CAJ1314/2027-smart-sorting-system-/双板通信测试说明.md

# 双板释放通信测试

分别打开 F407程序/Project.uvprojx 和 F103程序/Project.uvprojx，分别下载到对应芯片，不能交叉下载。

接线：F407 PD8(TX) -> F103 PA10(RX)；F407 PD9(RX) <- F103 PA9(TX)；两板GND相连。F103 SG90信号PA1。舵机使用合适独立电源并共地，不从GPIO取电。

F407 USART3 / F103 USART1：115200，8N1。RELEASE\r\n：释放请求；ACK\r\n：已接收；DONE\r\n：定时动作结束；ERR\r\n：无效指令。

先启动F103，舵机85度待机；再启动F407。上层保持现有PC7流程，XY正常到放料坐标并打开夹爪后等待500ms，发送一次RELEASE。下层设置5度并保持1000ms，再设置85度并等待500ms，回复DONE。打开保持时间从设置5度开始计时，并非检测到5度后计时；没有位置反馈。

F407最多等3000ms，无自动重发。超时后结束本轮，等待下一次按键，不是永久故障锁定。Debugger Watch：BoardUART_ReleaseStatus=0等待、1收到DONE、2超时；F103 Release_Count记录释放次数，Release_State=1动作中、0待机。

当前只测试通信和下层SG90，不启用转盘/光电门，不传类别。ACK/DONE无任务编号，仅适合此串行单任务测试；正式流程需加入任务编号、防重和故障处理。

仅已完成源码与Keil编译，未进行下载或硬件验证。先空载验证关闭/打开方向及机械限位，避免85度或5度造成堵转。
