CAJ1314/2027-smart-sorting-system-/F407程序/TJC屏幕资源_导入用/资源编号说明.txt

淘晶驰串口屏资源导入说明

物料图片_61x34\00.png 至 48.png 对应校赛备份中的49张表格缩略图。
F407代码图片ID从1开始：文件00.png -> 图片ID 1，依次递增，文件48.png -> 图片ID 49。
背景图建议作为图片ID 0。中文字库参考 font16.zi。
F407串口屏UI需要 page main，以及每行控件 tName0..5、pItem0..5、nCount0..5。
注意：原备份ZIP未包含可编辑HMI工程文件或编译后的TFT屏幕固件。
