CAJ1314/2027-smart-sorting-system-/F407程序/TJC屏幕资源_导入用/背景_480x272.png

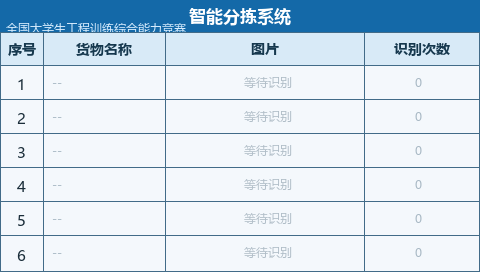
F407程序/TJC屏幕资源_导入用/背景_480x272.png
