CAJ1314/2027-smart-sorting-system-/装置零件建模/夹爪/上层集成支架.SLDPRT

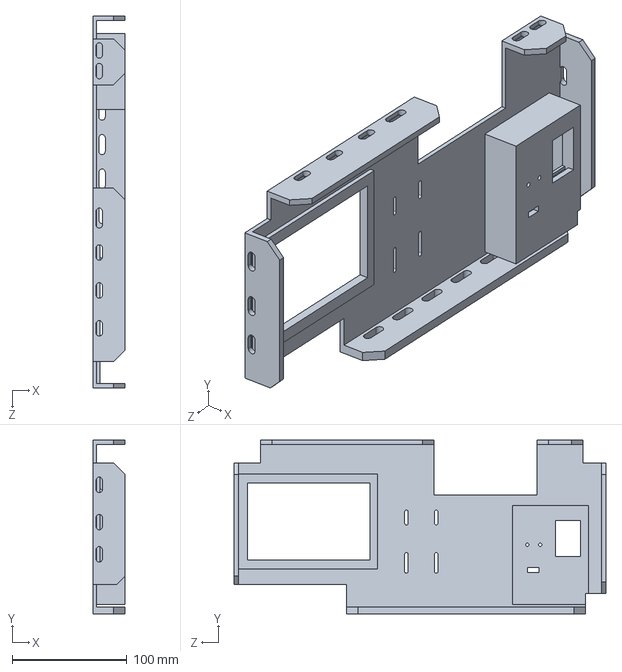
[picture p3: CAD file, 2026-11-10]
装置零件建模/夹爪/上层集成支架.SLDPRT
28.0 x 151.5 x 324.0 mm
