CAJ1314/2027-smart-sorting-system-/装置零件建模/夹爪/夹爪座.SLDPRT

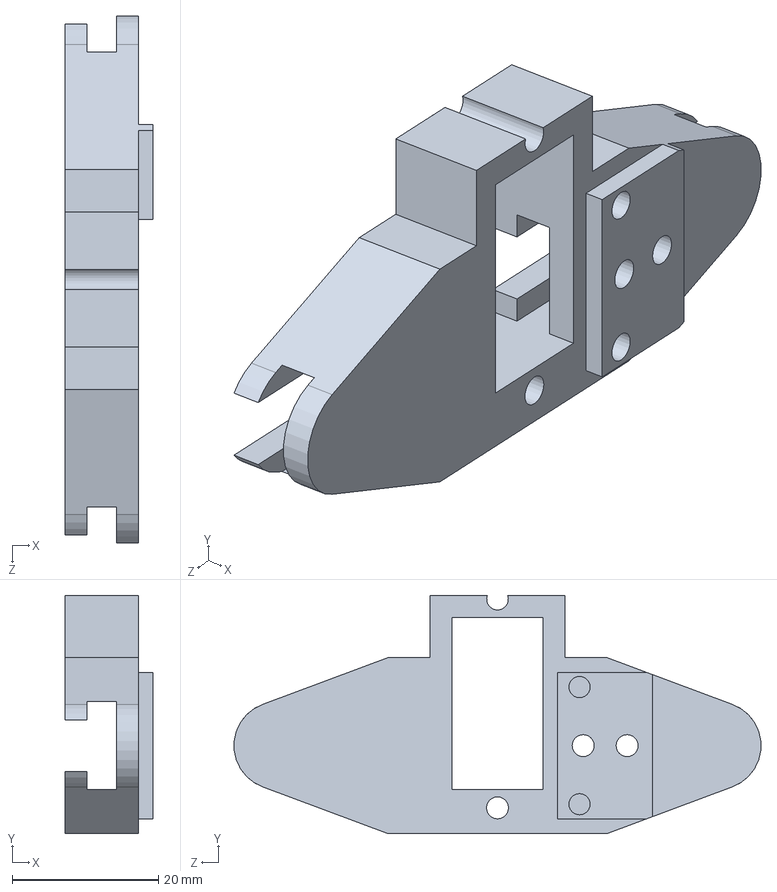
[picture p4: CAD file, 2026-11-10]
装置零件建模/夹爪/夹爪座.SLDPRT
12.0 x 32.5 x 71.9 mm
