CAJ1314/2027-smart-sorting-system-/装置零件建模/夹爪/摄像头2支架.SLDPRT

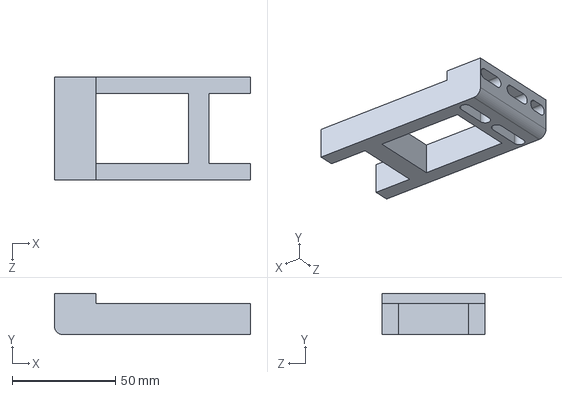
[picture p5: CAD file, 2026-11-10]
装置零件建模/夹爪/摄像头2支架.SLDPRT
95.0 x 20.0 x 50.0 mm
