CAJ1314/2027-smart-sorting-system-/装置零件建模/夹爪/圆框.SLDPRT

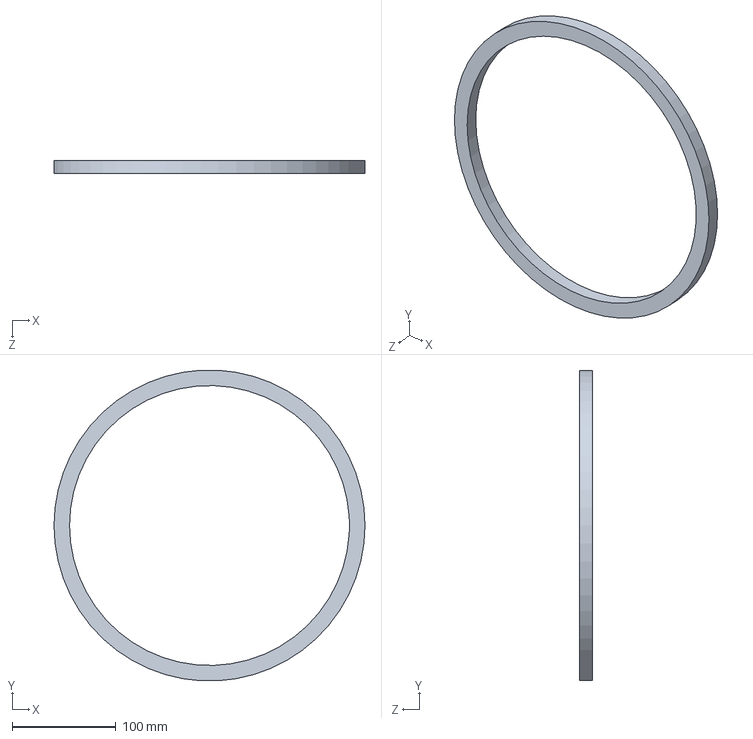
[picture p6: CAD file, 2026-11-10]
装置零件建模/夹爪/圆框.SLDPRT
300.0 x 299.5 x 13.0 mm
