CAJ1314/2027-smart-sorting-system-/装置零件建模/夹爪/y 轴滑轮固定.SLDPRT

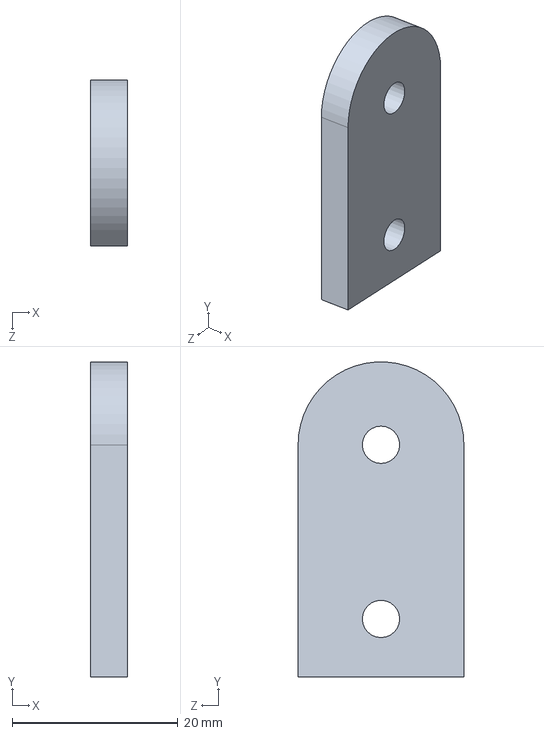
[picture p7: CAD file, 2026-11-10]
装置零件建模/夹爪/y 轴滑轮固定.SLDPRT
4.50 x 38.0 x 20.0 mm
