CAJ1314/2027-smart-sorting-system-/装置零件建模/夹爪/夹爪指.SLDPRT

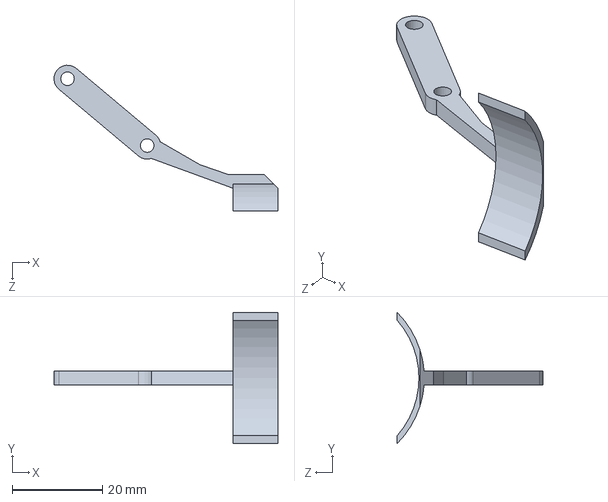
[picture p8: CAD file, 2026-11-10]
装置零件建模/夹爪/夹爪指.SLDPRT
49.5 x 29.0 x 32.2 mm
