CAJ1314/2027-smart-sorting-system-/装置零件建模/夹爪/夹爪盘.SLDPRT

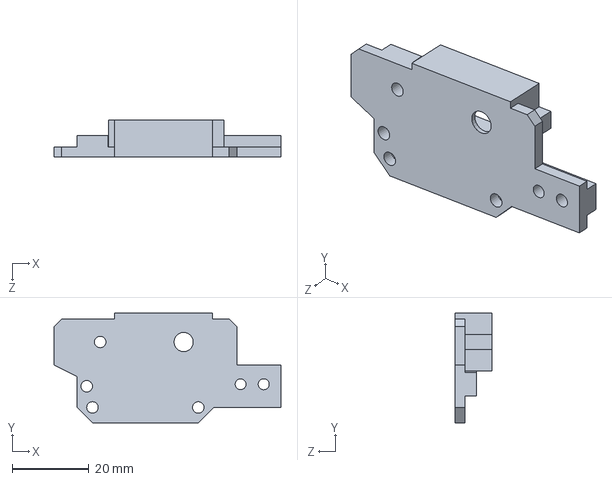
[picture p9: CAD file, 2026-11-10]
装置零件建模/夹爪/夹爪盘.SLDPRT
59.0 x 28.5 x 9.50 mm
