CAJ1314/2027-smart-sorting-system-/装置零件建模/夹爪/屏幕支架（新）.SLDPRT

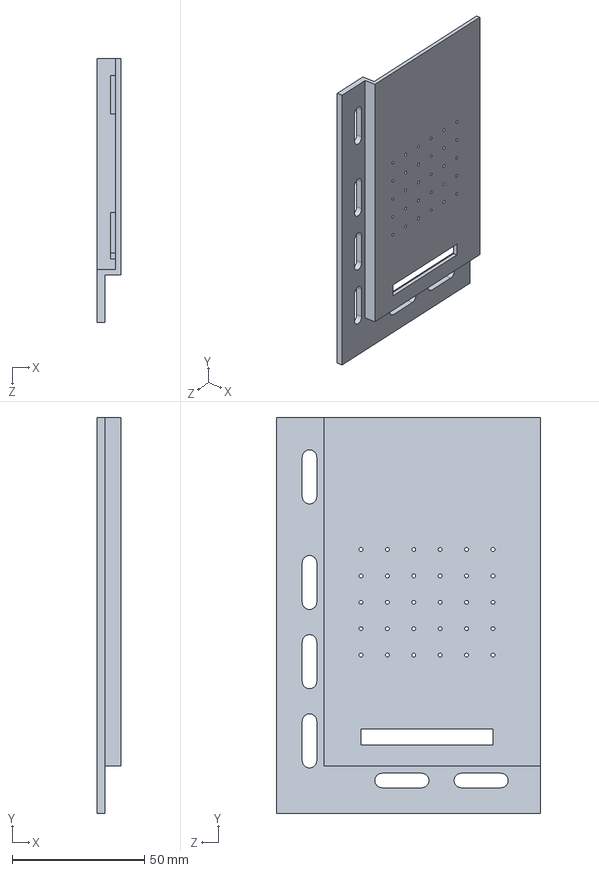
[picture p10: CAD file, 2026-11-10]
装置零件建模/夹爪/屏幕支架（新）.SLDPRT
9.00 x 150.0 x 100.0 mm
