CAJ1314/2027-smart-sorting-system-/装置零件建模/夹爪/夹轮板（上）.SLDPRT

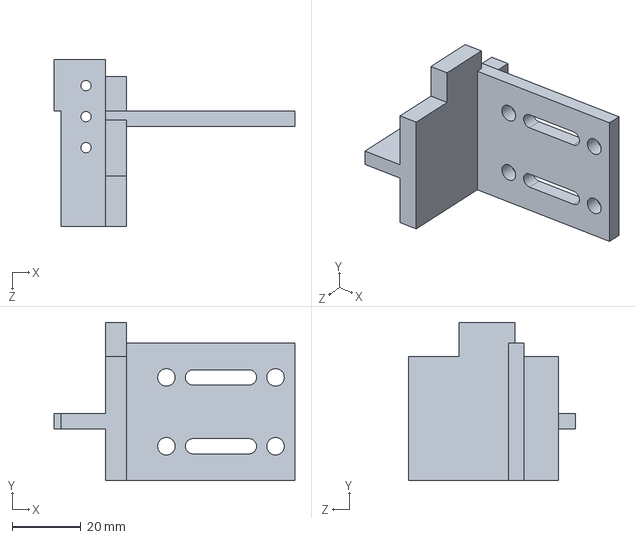
[picture p11: CAD file, 2026-11-10]
装置零件建模/夹爪/夹轮板（上）.SLDPRT
70.0 x 46.0 x 48.5 mm
