CAJ1314/2027-smart-sorting-system-/装置零件建模/夹爪/z.SLDPRT

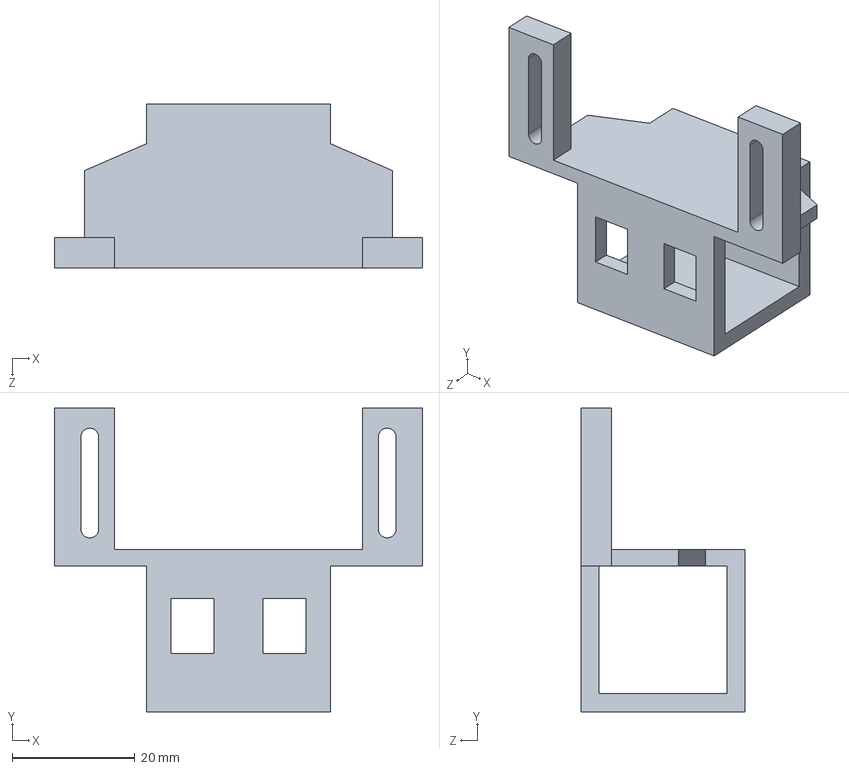
[picture p12: CAD file, 2026-11-10]
装置零件建模/夹爪/z.SLDPRT
60.0 x 49.5 x 26.8 mm
