CAJ1314/2027-smart-sorting-system-/装置零件建模/夹爪/电源座.SLDPRT

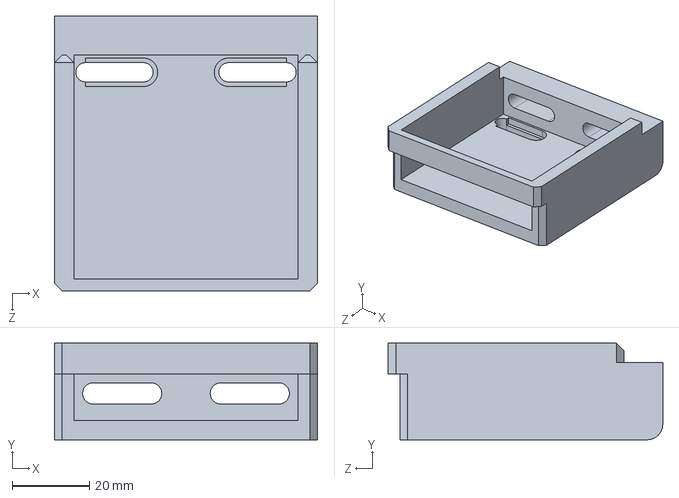
[picture p13: CAD file, 2026-11-10]
装置零件建模/夹爪/电源座.SLDPRT
68.0 x 25.0 x 71.0 mm
