CAJ1314/2027-smart-sorting-system-/装置零件建模/夹爪/夹爪连接器.SLDPRT

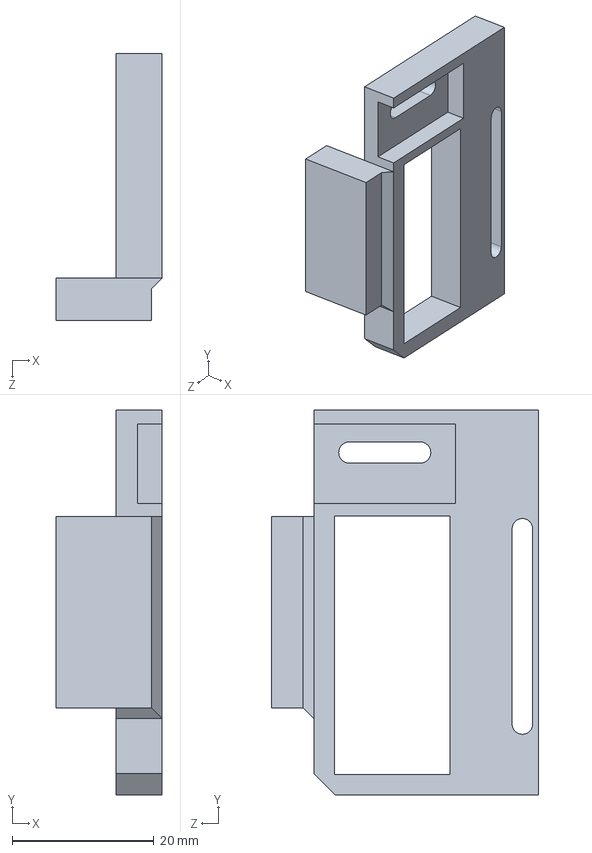
[picture p14: CAD file, 2026-11-10]
装置零件建模/夹爪/夹爪连接器.SLDPRT
15.0 x 54.3 x 37.7 mm
