CAJ1314/2027-smart-sorting-system-/装置零件建模/夹爪/识别平台.SLDPRT

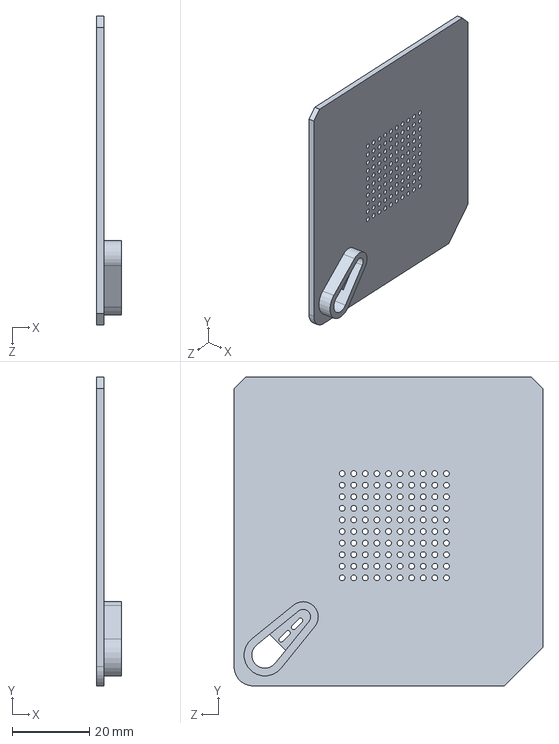
[picture p15: CAD file, 2026-11-10]
装置零件建模/夹爪/识别平台.SLDPRT
6.50 x 80.0 x 80.0 mm
