CAJ1314/2027-smart-sorting-system-/装置零件建模/夹爪/下层控制板支架.SLDPRT

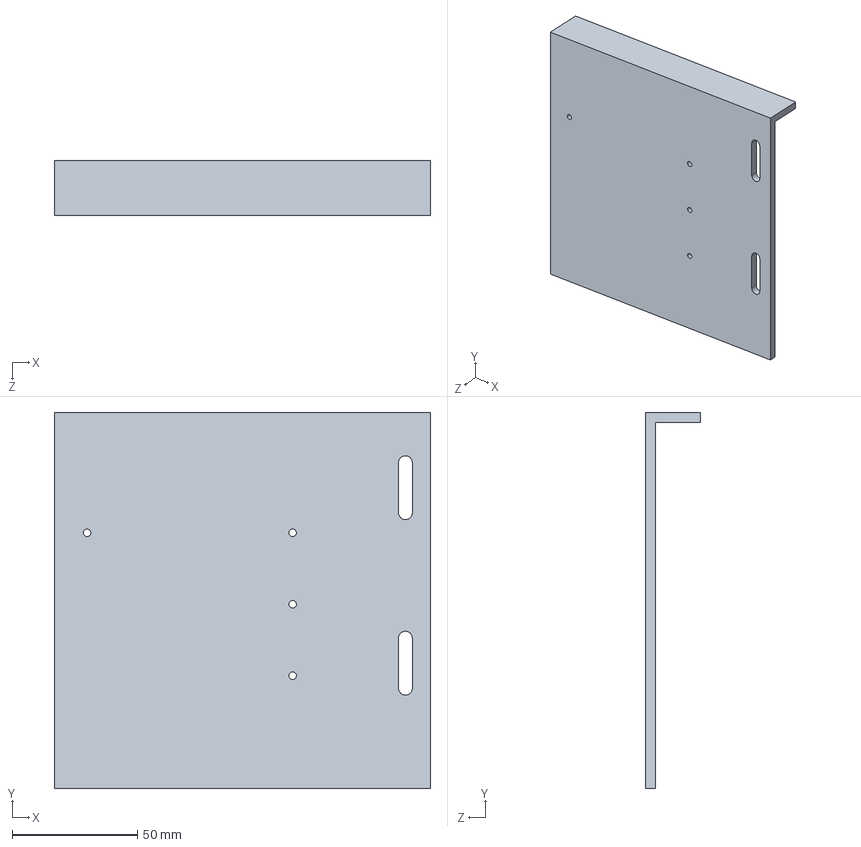
[picture p16: CAD file, 2026-11-10]
装置零件建模/夹爪/下层控制板支架.SLDPRT
150.0 x 150.0 x 22.0 mm
