CAJ1314/2027-smart-sorting-system-/装置零件建模/夹爪/夹轮板（下）.SLDPRT

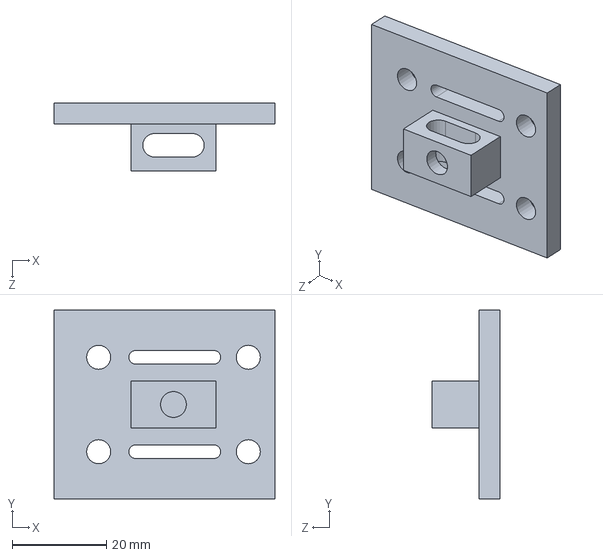
[picture p17: CAD file, 2026-11-10]
装置零件建模/夹爪/夹轮板（下）.SLDPRT
46.8 x 40.0 x 14.5 mm
