CAJ1314/2027-smart-sorting-system-/装置零件建模/夹爪/爪片.SLDPRT

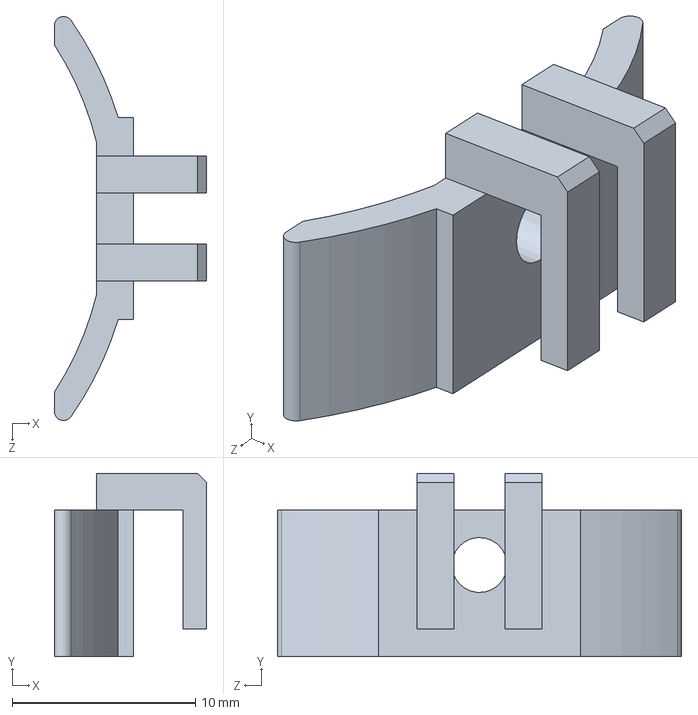
[picture p18: CAD file, 2026-11-10]
装置零件建模/夹爪/爪片.SLDPRT
8.30 x 10.0 x 22.0 mm
