CAJ1314/2027-smart-sorting-system-/装置零件建模/夹爪/摄像头1支架.SLDPRT

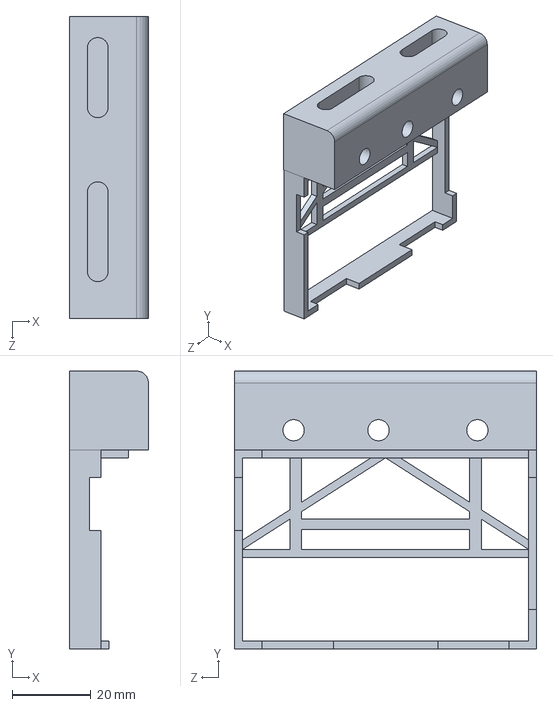
[picture p19: CAD file, 2026-11-10]
装置零件建模/夹爪/摄像头1支架.SLDPRT
20.0 x 70.4 x 76.5 mm
