CAJ1314/2027-smart-sorting-system-/装置零件建模/夹爪/开关架.SLDPRT

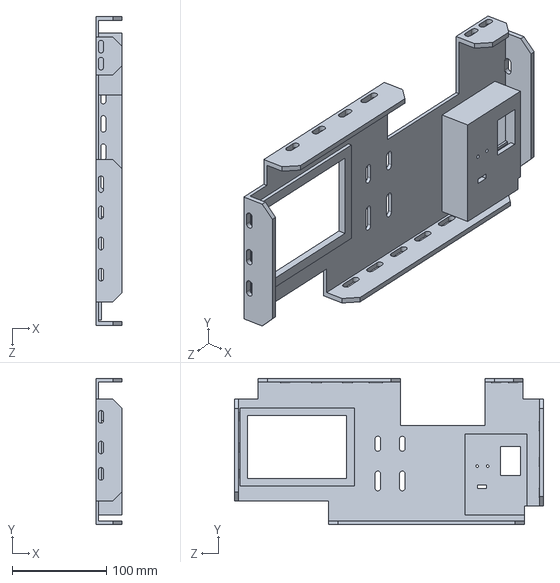
[picture p20: CAD file, 2026-11-10]
装置零件建模/夹爪/开关架.SLDPRT
28.0 x 155.5 x 328.0 mm
