CAJ1314/2027-smart-sorting-system-/装置零件建模/夹爪/滑片体.SLDPRT

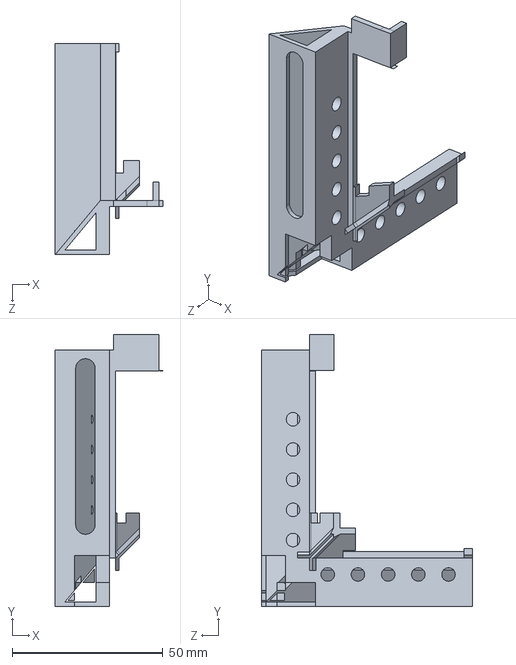
[picture p21: CAD file, 2026-11-10]
装置零件建模/夹爪/滑片体.SLDPRT
35.7 x 90.1 x 70.0 mm
