CAJ1314/2027-smart-sorting-system-/装置零件建模/夹爪/挡片.SLDPRT

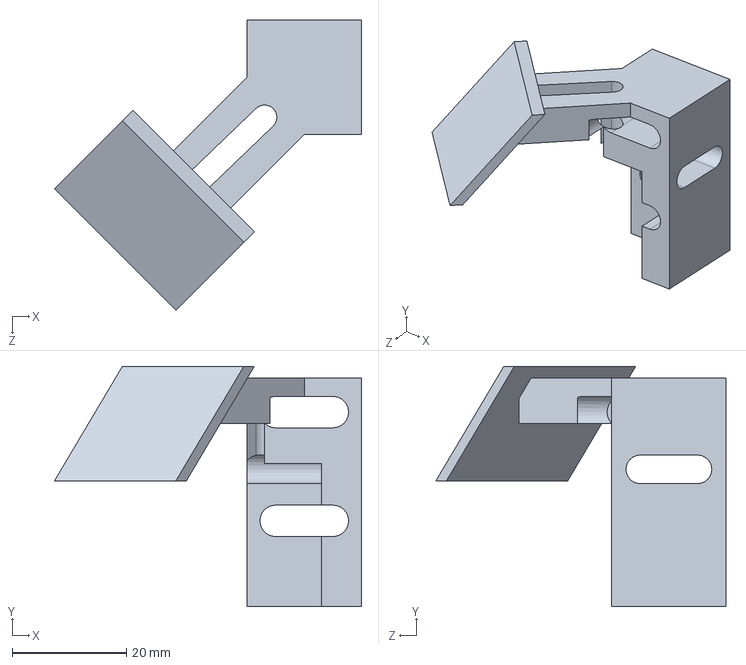
[picture p22: CAD file, 2026-11-10]
装置零件建模/夹爪/挡片.SLDPRT
53.7 x 42.0 x 50.7 mm
