CAJ1314/2027-smart-sorting-system-/装置零件建模/夹爪/料盘.SLDPRT

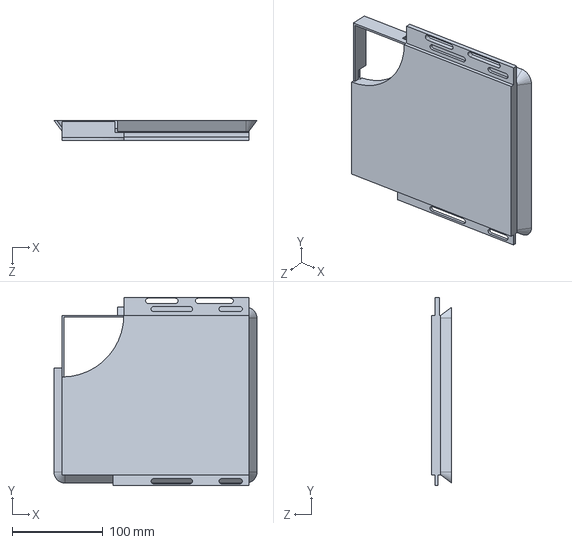
[picture p23: CAD file, 2026-11-10]
装置零件建模/夹爪/料盘.SLDPRT
224.0 x 208.0 x 22.0 mm
