CAJ1314/2027-smart-sorting-system-/装置零件建模/夹爪/连杆.SLDPRT

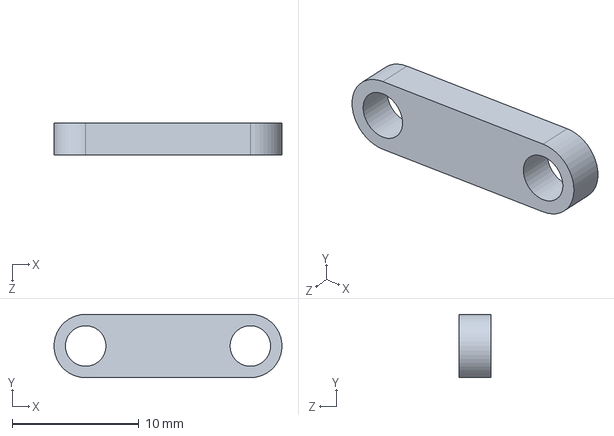
[picture p24: CAD file, 2026-11-10]
装置零件建模/夹爪/连杆.SLDPRT
18.0 x 5.00 x 2.50 mm
