CAJ1314/2027-smart-sorting-system-/装置零件建模/夹爪/舵机吊架.SLDPRT

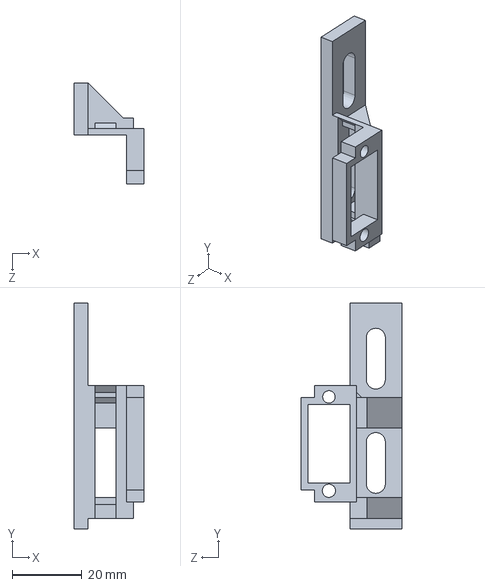
[picture p25: CAD file, 2026-11-10]
装置零件建模/夹爪/舵机吊架.SLDPRT
20.0 x 65.0 x 29.0 mm
