CAJ1314/2027-smart-sorting-system-/装置零件建模/夹爪/摄像头支架（全局）.SLDPRT

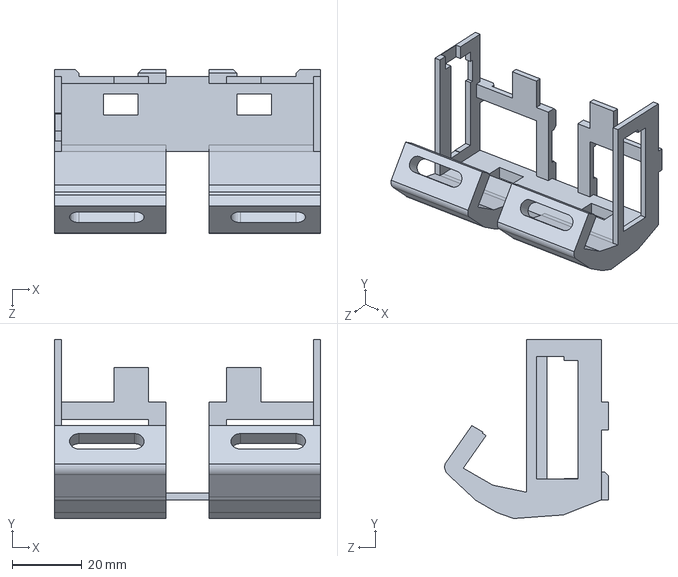
[picture p26: CAD file, 2026-11-10]
装置零件建模/夹爪/摄像头支架（全局）.SLDPRT
76.3 x 51.4 x 47.0 mm
