CAJ1314/2027-smart-sorting-system-/(list of files, cad)

Other CAD files:
装置零件建模/夹爪/夹爪盘.3mf
装置零件建模/夹爪/滑片体.3mf
