CAJ1314/2027-smart-sorting-system-/F103程序/Hardware/Servo.c

#include "stm32f10x.h"                  // Device header
#include "PWM.h"

void Servo_Init(void)
{
	PWM_Init();
}

void Servo_SetAngle(float Angle)//调整舵机角度
{
	PWM_SetCompare2(Angle / 180 * 2000 + 500);
}
