CAJ1314/2027-smart-sorting-system-/F407程序/System/ScreenTable.c

#include "ScreenTable.h"
#include "ILI9341.h"
#include "BlockPicture.h"
#include "SpherePicture.h"
#include "Delay.h"

/* User-provided 16x16 glyphs: row first, bit7 is leftmost. */
static const uint8_t FONT_XU[32] = { /* 序 */
    0x01,0x00,0x00,0x80,0x3f,0xfe,0x20,0x00,0x23,0xf8,0x20,0x10,0x20,0xa0,0x20,0x40,0x2f,0xfe,0x20,0x42,0x20,0x44,0x20,0x40,0x40,0x40,0x40,0x40,0x81,0x40,0x00,0x80
};
static const uint8_t FONT_HAO[32] = { /* 号 */
    0x00,0x00,0x1f,0xf0,0x10,0x10,0x10,0x10,0x10,0x10,0x1f,0xf0,0x00,0x00,0xff,0xfe,0x08,0x00,0x10,0x00,0x1f,0xf0,0x00,0x10,0x00,0x10,0x00,0x10,0x00,0xa0,0x00,0x40
};
static const uint8_t FONT_HUO[32] = { /* 货 */
    0x08,0x80,0x08,0x80,0x10,0x98,0x30,0xe0,0x57,0x84,0x90,0x84,0x10,0x7c,0x00,0x00,0x1f,0xf0,0x10,0x10,0x11,0x10,0x11,0x10,0x11,0x10,0x02,0x60,0x0c,0x18,0x70,0x04
};
static const uint8_t FONT_WU[32] = { /* 物 */
    0x10,0x80,0x10,0x80,0x50,0x80,0x50,0xfc,0x7d,0x54,0x52,0x54,0x90,0x54,0x10,0x94,0x1c,0x94,0xf1,0x24,0x52,0x24,0x10,0x44,0x10,0x44,0x10,0x84,0x11,0x28,0x10,0x10
};
static const uint8_t FONT_MING[32] = { /* 名 */
    0x02,0x00,0x02,0x00,0x07,0xf0,0x08,0x10,0x14,0x20,0x62,0x40,0x02,0x80,0x01,0x00,0x06,0x00,0x1f,0xf8,0xe8,0x08,0x08,0x08,0x08,0x08,0x08,0x08,0x0f,0xf8,0x08,0x08
};
static const uint8_t FONT_CHENG[32] = { /* 称 */
    0x08,0x80,0x1c,0x80,0xf0,0x80,0x10,0xfe,0x11,0x02,0xfd,0x04,0x12,0x20,0x30,0x20,0x38,0xa8,0x54,0xa4,0x51,0x24,0x91,0x22,0x12,0x22,0x10,0x20,0x10,0xa0,0x10,0x40
};
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
};

static const uint8_t FONT_SHU[32] = { /* 数 */
    0x08,0x20,0x49,0x20,0x2a,0x20,0x08,0x3e,0xff,0x44,0x2a,0x44,0x49,0x44,0x88,0xa4,0x10,0x28,0xfe,0x28,0x22,0x10,0x42,0x10,0x64,0x28,0x18,0x28,0x34,0x44,0xc2,0x82
};

/* A small RGB565 buffer sends a glyph as one rectangle. */
static void DrawGlyph(uint16_t x, uint16_t y, const uint8_t *glyph)
{
    uint8_t pixels[16 * 16 * 2];
    uint16_t row, col, color, index;
    for (row = 0; row < 16; row++) {
        for (col = 0; col < 16; col++) {
            color = (glyph[row * 2 + col / 8] & (0x80u >> (col % 8)))
                    ? ILI9341_BLACK : ILI9341_WHITE;
            index = (row * 16 + col) * 2;
            pixels[index] = (uint8_t)(color >> 8);
            pixels[index + 1] = (uint8_t)color;
        }
    }
    ILI9341_DrawImageRGB565(x, y, 16, 16, pixels, sizeof(pixels));
}

void ScreenTable_Init(void)
{
    ILI9341_Init();
    Delay_ms(20U);
}

void ScreenTable_DrawFrame(void)
{
    static const uint16_t columns[] = {1, 29, 99, 201, 238};
    static const uint16_t rows[] = {1, 53, 97, 141, 185, 229, 273, 318};
    uint8_t i;

    ILI9341_FillScreen(ILI9341_WHITE);
    for (i = 0; i < sizeof(columns) / sizeof(columns[0]); i++)
        ILI9341_FillRect(columns[i], 1, 1, 318, ILI9341_BLACK);
    for (i = 0; i < sizeof(rows) / sizeof(rows[0]); i++)
        ILI9341_FillRect(1, rows[i], 238, 1, ILI9341_BLACK);

    DrawGlyph(7, 8, FONT_XU);
    DrawGlyph(7, 28, FONT_HAO);
    DrawGlyph(48, 8, FONT_HUO);
    DrawGlyph(64, 8, FONT_WU);
    DrawGlyph(48, 28, FONT_MING);
    DrawGlyph(64, 28, FONT_CHENG);
    DrawGlyph(134, 19, FONT_TU);
    DrawGlyph(150, 19, FONT_PIAN);
    DrawGlyph(204, 8, FONT_SHI);
    DrawGlyph(220, 8, FONT_BIE);
    DrawGlyph(204, 28, FONT_CI);
    DrawGlyph(220, 28, FONT_SHU);
}

static void DrawShapeName(uint8_t shape, uint16_t x, uint16_t y)
{
    switch (shape)
    {
        case 1U:
            DrawGlyph(x, y, FONT_ZHENG); DrawGlyph(x + 16U, y, FONT_FANG); DrawGlyph(x + 32U, y, FONT_TI);
            break;
        case 2U:
            DrawGlyph(x, y, FONT_LIU); DrawGlyph(x + 16U, y, FONT_LENG); DrawGlyph(x + 32U, y, FONT_ZHU);
            break;
        case 3U:
            DrawGlyph(x, y, FONT_SAN); DrawGlyph(x + 16U, y, FONT_LENG); DrawGlyph(x + 32U, y, FONT_ZHUI);
            break;
        case 4U:
            DrawGlyph(x, y, FONT_QIU);
            break;
        case 5U:
            DrawGlyph(x, y, FONT_WU2); DrawGlyph(x + 16U, y, FONT_LENG); DrawGlyph(x + 32U, y, FONT_ZHU);
            break;
        case 6U:
            DrawGlyph(x, y, FONT_YUAN); DrawGlyph(x + 16U, y, FONT_ZHU);
            break;
        case 7U:
            DrawGlyph(x, y, FONT_CHANG); DrawGlyph(x + 16U, y, FONT_FANG); DrawGlyph(x + 32U, y, FONT_TI);
            break;
        default:
            break;
    }
}

static const uint8_t FONT_D1[16] = {
    0x00,0x00,0x00,0x08,0x38,0x08,0x08,0x08,0x08,0x08,0x08,0x08,0x08,0x3E,0x00,0x00
};
static const uint8_t FONT_D2[16] = {
    0x00,0x00,0x00,0x3C,0x42,0x42,0x42,0x02,0x04,0x08,0x10,0x20,0x42,0x7E,0x00,0x00
};
static const uint8_t FONT_D3[16] = {
    0x00,0x00,0x00,0x3C,0x42,0x42,0x02,0x04,0x18,0x04,0x02,0x42,0x42,0x3C,0x00,0x00
};
static const uint8_t FONT_D4[16] = {
    0x00,0x00,0x00,0x04,0x0C,0x0C,0x14,0x24,0x24,0x44,0x7F,0x04,0x04,0x1F,0x00,0x00
};
static const uint8_t FONT_D5[16] = {
    0x00,0x00,0x00,0x7E,0x40,0x40,0x40,0x78,0x44,0x02,0x02,0x42,0x44,0x38,0x00,0x00
};
static const uint8_t FONT_D6[16] = {
    0x00,0x00,0x00,0x18,0x24,0x40,0x40,0x5C,0x62,0x42,0x42,0x42,0x22,0x1C,0x00,0x00
};

/* 8x16 digit, row first, bit7 leftmost. Returns 0 when the digit has no glyph. */
static uint8_t DrawDigit(uint16_t x, uint16_t y, uint8_t d)
{
    const uint8_t *g;
    uint8_t pixels[8 * 16 * 2];
    uint16_t row, col, color, index;

    switch (d)
    {
        case 1U: g = FONT_D1; break;
        case 2U: g = FONT_D2; break;
        case 3U: g = FONT_D3; break;
        case 4U: g = FONT_D4; break;
        case 5U: g = FONT_D5; break;
        case 6U: g = FONT_D6; break;
        default: return 0U;
    }

    for (row = 0U; row < 16U; row++)
    {
        for (col = 0U; col < 8U; col++)
        {
            color = (g[row] & (0x80u >> col)) ? ILI9341_BLACK : ILI9341_WHITE;
            index = (uint16_t)((row * 8U + col) * 2U);
            pixels[index] = (uint8_t)(color >> 8);
            pixels[index + 1] = (uint8_t)color;
        }
    }
    ILI9341_DrawImageRGB565(x, y, 8U, 16U, pixels, sizeof(pixels));
    return 1U;
}
/* Keyed by the full (color, shape) category, but only the shape is drawn. */
static uint8_t ScreenCategory[6] = {0U, 0U, 0U, 0U, 0U, 0U};
static uint8_t ScreenCount[6] = {0U, 0U, 0U, 0U, 0U, 0U};

/* category = color * 8 + shape. Unknown color (0) falls back to color 1. */
static const uint8_t *CategoryPicture(uint8_t category)
{
    uint8_t color = (uint8_t)(category / 8U);
    uint8_t shape = (uint8_t)(category % 8U);

    if (shape < 1U || shape > 7U) return 0;
    if (color < 1U || color > 7U) color = 1U;
    if (shape == 4U) return g_sphere_picture[color - 1U];
    return g_block_picture[(uint8_t)((color - 1U) * 7U + (shape - 1U))];
}

static void ClearDataRow(uint8_t slot)
{
    uint16_t y = (uint16_t)(54U + slot * 44U);

    /* Clear cell interiors only; keep the black grid lines intact. */
    ILI9341_FillRect(2U, y, 26U, 42U, ILI9341_WHITE);   /* 序号 */
    ILI9341_FillRect(30U, y, 68U, 42U, ILI9341_WHITE);  /* 名称 */
    ILI9341_FillRect(100U, y, 100U, 42U, ILI9341_WHITE);/* 图片 */
    ILI9341_FillRect(202U, y, 35U, 42U, ILI9341_WHITE); /* 次数 */
}

void ScreenTable_ResetData(void)
{
    uint8_t i;
    for (i = 0U; i < 6U; ++i)
    {
        ScreenCategory[i] = 0U;
        ScreenCount[i] = 0U;
        ClearDataRow(i);
    }
}

void ScreenTable_UpdateItem(uint8_t shape, uint8_t category)
{
    uint8_t i;
    uint8_t slot = 6U;
    uint16_t y;
    char text[4];

    if (shape < 1U || shape > 7U || category == 0U) return;

    for (i = 0U; i < 6U; ++i)
    {
        if (ScreenCategory[i] == category)
        {
            slot = i;
            break;
        }
    }

    if (slot == 6U)
    {
        for (i = 0U; i < 6U; ++i)
        {
            if (ScreenCategory[i] == 0U)
            {
                slot = i;
                ScreenCategory[i] = category;
                break;
            }
        }
    }

    if (slot == 6U) return;

    ScreenCount[slot]++;
    y = (uint16_t)(54U + slot * 44U);

    ClearDataRow(slot);

    if (DrawDigit(7U, (uint16_t)(y + 13U), (uint8_t)(slot + 1U)) == 0U)
    {
        text[0] = (char)('1' + slot);
        text[1] = '\0';
        ILI9341_DrawString(7U, (uint16_t)(y + 13U), text, ILI9341_BLACK, ILI9341_WHITE, 1U);
    }

    DrawShapeName(shape, 40U, (uint16_t)(y + 13U));

    {
        const uint8_t *picture = CategoryPicture(category);
        if (picture != 0)
        {
            ILI9341_DrawImageRGB565(114U, (uint16_t)(y + 1U),
                BLOCK_PICTURE_W, BLOCK_PICTURE_HEIGHT, picture, BLOCK_PICTURE_BYTES);
        }
    }

    if (DrawDigit(211U, (uint16_t)(y + 13U), ScreenCount[slot]) == 0U)
    {
        if (ScreenCount[slot] < 10U)
        {
            text[0] = (char)('0' + ScreenCount[slot]);
            text[1] = '\0';
        }
        else
        {
            text[0] = (char)('0' + (ScreenCount[slot] / 10U));
            text[1] = (char)('0' + (ScreenCount[slot] % 10U));
            text[2] = '\0';
        }
        ILI9341_DrawString(211U, (uint16_t)(y + 13U), text, ILI9341_BLACK, ILI9341_WHITE, 1U);
    }
}
