CAJ1314/2027-smart-sorting-system-/F407程序/System/SpherePicture.h

#ifndef SPHERE_PICTURE_H_INCLUDED
#define SPHERE_PICTURE_H_INCLUDED

#include "stm32f4xx.h"

/* Seven 72x40 RGB565 sphere thumbnails, ordered by VisionUART color ID. */
#define SPHERE_PICTURE_COUNT 7U
#define SPHERE_PICTURE_W 72U
#define SPHERE_PICTURE_H 40U
#define SPHERE_PICTURE_BYTES (SPHERE_PICTURE_W * SPHERE_PICTURE_H * 2U)

static const uint8_t g_sphere_picture[SPHERE_PICTURE_COUNT][SPHERE_PICTURE_BYTES] = {
    { /* red */
        0x6b,0x2d,0x63,0x4d,0x6b,0x4d,0x6b,0x4d,0x6b,0x4d,0x6b,0x4d,0x6b,0x4d,0x6b,0x4d,0x6b,0x4d,0x6b,0x4d,0x6b,0x6d,0x6b,0x8e,
        0x6b,0x8e,0x6b,0x8e,0x6b,0x6d,0x6b,0x6e,0x6b,0x6e,0x6b,0x8e,0x6b,0x8e,0x6b,0x8e,0x6b,0x8e,0x73,0x8e,0x73,0xae,0x73,0xaf,
        0x73,0xaf,0x73,0xcf,0x73,0xcf,0x73,0xcf,0x73,0xcf,0x7b,0xcf,0x7b,0xcf,0x7b,0xcf,0x7b,0xef,0x7b,0xef,0x7b,0xef,0x7b,0xcf,
        0x7b,0xf0,0x7b,0xef,0x7b,0xf0,0x7b,0xef,0x7b,0xef,0x7b,0xef,0x7b,0xcf,0x7b,0xcf,0x7b,0xcf,0x7b,0xcf,0x73,0xcf,0x73,0xcf,
        0x73,0xcf,0x73,0xcf,0x73,0xcf,0x73,0xaf,0x73,0x8f,0x6b,0x8e,0x6b,0x8e,0x6b,0x8e,0x6b,0x8e,0x6b,0x8e,0x6b,0x8e,0x6b,0x4d,
        0x63,0x2d,0x5a,0xeb,0x5a,0xcb,0x52,0xcb,0x52,0xaa,0x42,0x28,0x29,0x65,0x21,0x04,0x10,0xa3,0x10,0xa3,0x10,0xa3,0x18,0xc3,
        0x63,0x4d,0x63,0x4d,0x6b,0x4d,0x6b,0x4d,0x6b,0x4d,0x6b,0x4d,0x6b,0x4d,0x6b,0x4d,0x6b,0x4d,0x6b,0x4d,0x6b,0x8d,0x6b,0x8e,
        0x6b,0x8e,0x6b,0x8e,0x6b,0x8e,0x6b,0x8e,0x73,0x8e,0x73,0x8e,0x73,0x8e,0x73,0x8e,0x73,0xae,0x73,0xce,0x73,0xcf,0x73,0xcf,
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
        0x7b,0xcf,0x7b,0xef,0x7b,0xef,0x7c,0x2f,0x7c,0x2f,0x7c,0x2f,0x7c,0x2f,0x7c,0x2f,0x7c,0x30,0x7c,0x30,0x7c,0x30,0x7c,0x30,
        0x7c,0x30,0x7c,0x30,0x7c,0x30,0x7c,0x30,0x7c,0x30,0x7c,0x30,0x7c,0x30,0x7c,0x30,0x7c,0x30,0x7c,0x2f,0x7c,0x2f,0x74,0x30,
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
    },
};

#endif
