CAJ1314/2027-smart-sorting-system-/(commit log)

2026-11-10 feat: 智能分拣系统第二版（F407主控 + F103协处理）
    - F407：主分拣流程、XY/Z轴步进控制、夹爪舵机、下层转盘六工位定位
    - F407：双K230相机串口解析（坐标/颜色/形状）、ILI9341状态显示
    - F103：6路光电门采集上报、释放机构SG90时序控制
    - 双板 USART3/USART1 115200 8N1 握手协议（RELEASE/ACK/DONE）
    - 按(颜色,形状)组合分类，支持正方体/圆柱/长方体差异化抓取参数
    - 添加 README 与 .gitignore（排除构建产物与历史备份）
    [智能分拣系统接线汇总.xlsx]
2026-11-10 feat(model): 添加夹爪装置零件建模文件（SolidWorks 源文件）
    - 25 个 .SLDPRT SolidWorks 零件源文件（夹爪、支架、料盘、摄像头支架等）
    - 2 个 .3mf 切片文件（夹爪盘、滑片体）
    - .gitignore 排除 STL/STEP/IGS 网格导出格式与 SolidWorks 临时锁文件
    [y 轴滑轮固定.SLDPRT, z.SLDPRT, 上层集成支架.SLDPRT, 下层控制板支架.SLDPRT, 圆框.SLDPRT, 夹爪座.SLDPRT, 夹爪指.SLDPRT, 夹爪盘.3mf]
2026-11-10 docs: README 添加整机实物图
    - 新增 docs/images/device.jpg 整机实物照片
    - README 顶部添加「实物展示」章节
    - 目录结构补充 装置零件建模/ 与 docs/images/
2026-11-10 feat(vision): 添加 K230 视觉识别程序
    - object_priority_uart_two_stage.py：第一相机 YOLO26 七类检测，输出抓取坐标 TARGET,1,<形状>,<颜色>,X,Y,CM
    - k230_video_wukuaicapture.py：第二相机 YOLO11 颜色+形状识别，输出 SHAPE:<形状>,COLOR:<颜色>
    - README 新增 K230 视觉程序章节（识别能力/关键技术/部署说明）
